KamalaIssack/Mecanum-wheel-mobile-robot-project/docs/images/hardware/buck-converter-adjustment.jpg

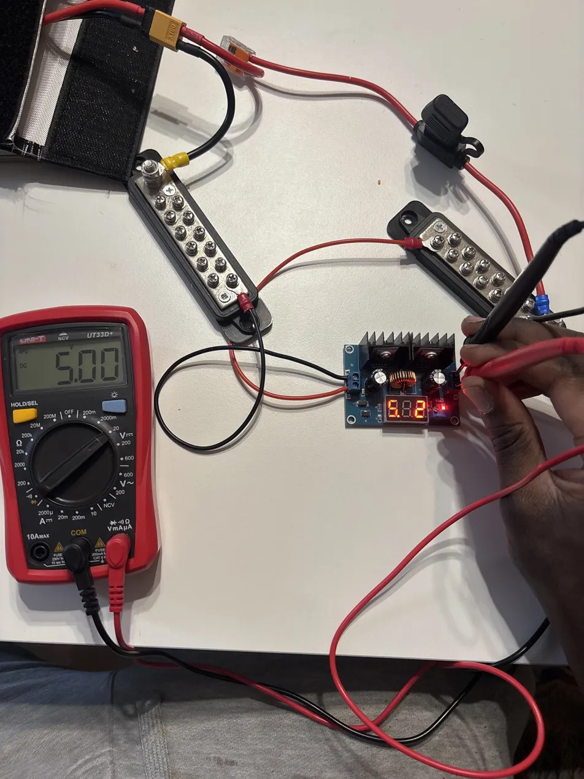
docs/images/hardware/buck-converter-adjustment.jpg
