KamalaIssack/Mecanum-wheel-mobile-robot-project/docs/images/ros2/urdf_foxglove_view.png

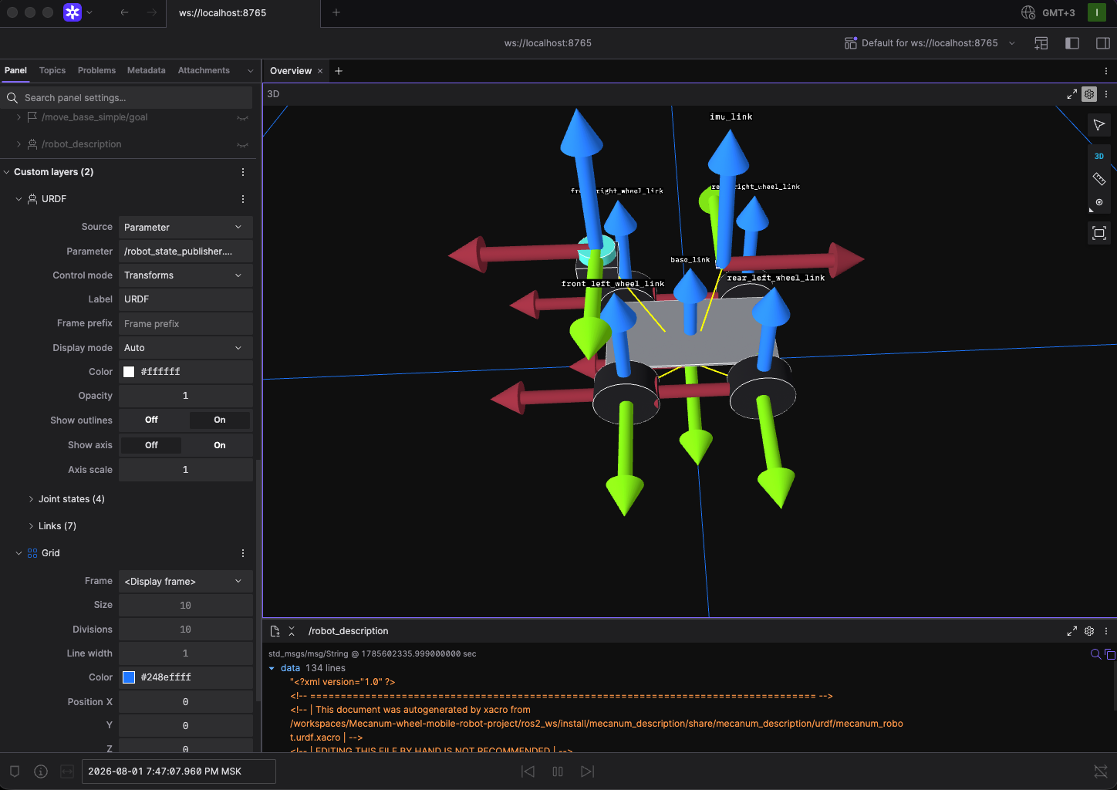
docs/images/ros2/urdf_foxglove_view.png
