KamalaIssack/Mecanum-wheel-mobile-robot-project/docs/images/stm32/phase1-led-blink.jpeg

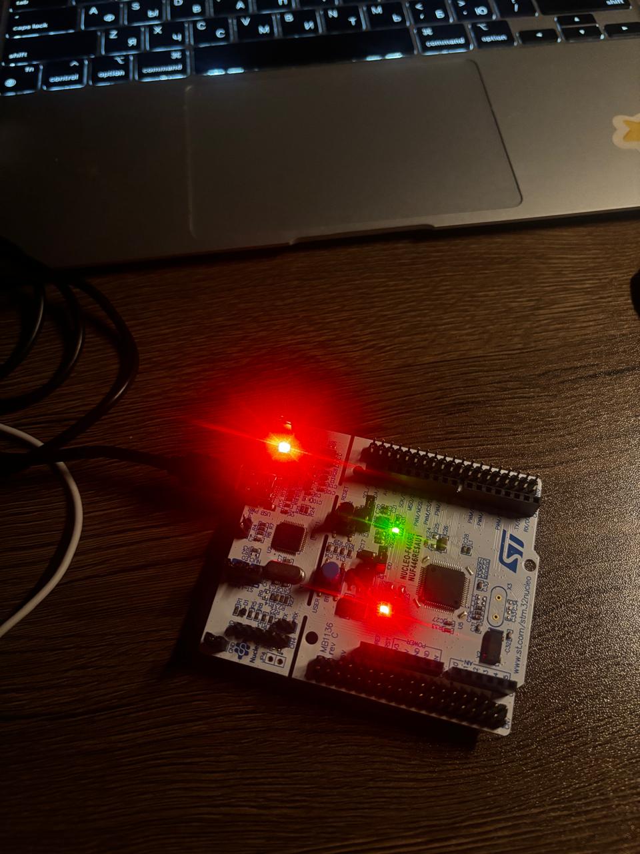
docs/images/stm32/phase1-led-blink.jpeg
