KamalaIssack/Mecanum-wheel-mobile-robot-project/docs/images/stm32/phase2-pwm-led.jpeg

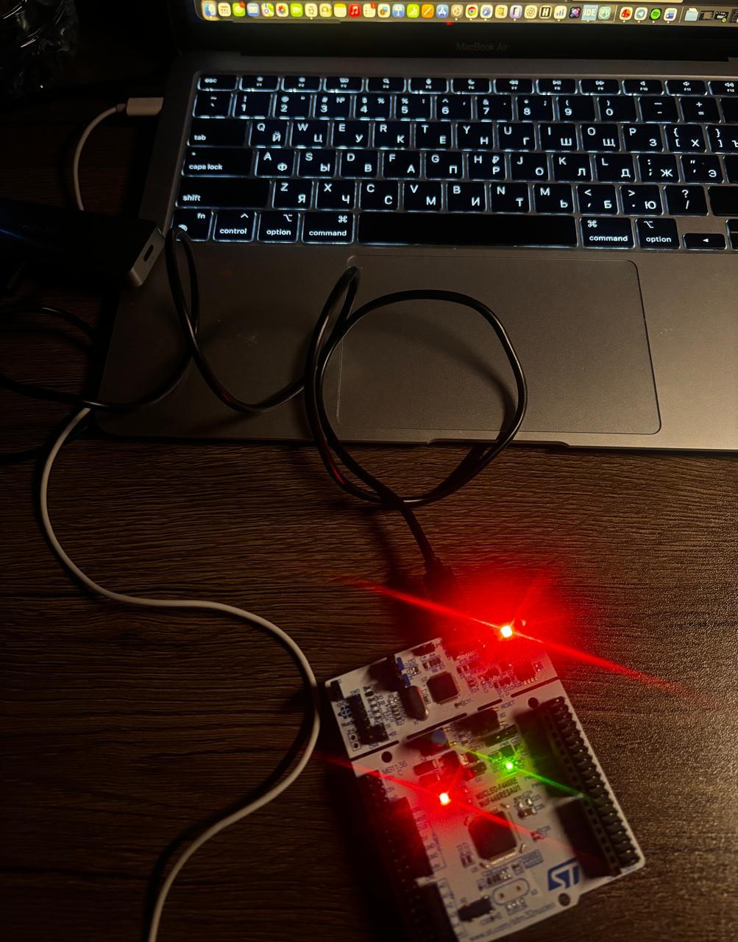
docs/images/stm32/phase2-pwm-led.jpeg
