KamalaIssack/Mecanum-wheel-mobile-robot-project/docs/images/wiring_step2.jpg

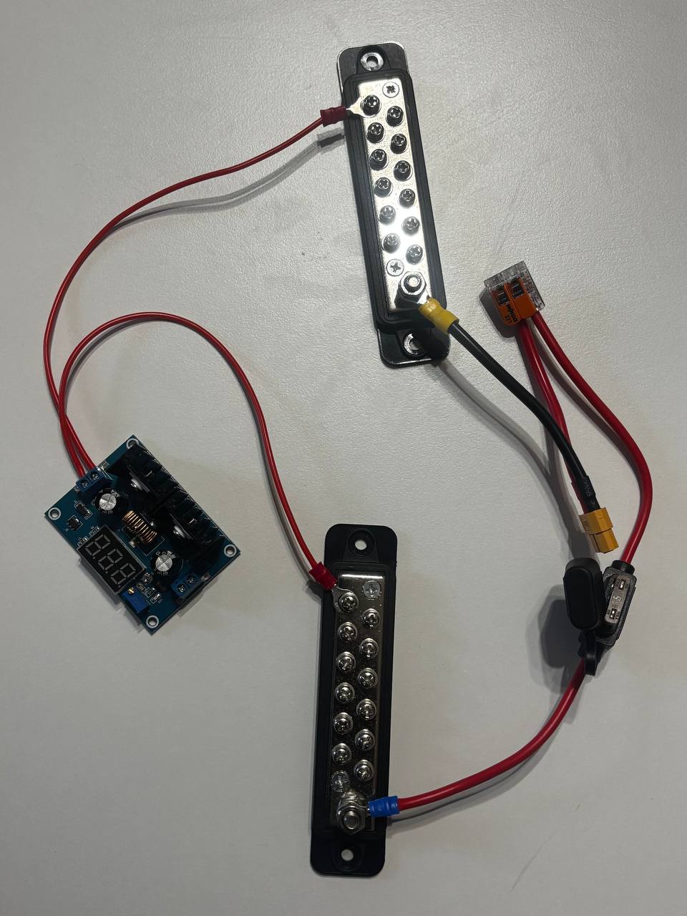
docs/images/wiring_step2.jpg
