KamalaIssack/Mecanum-wheel-mobile-robot-project/docs/images/wiring_step3.jpeg

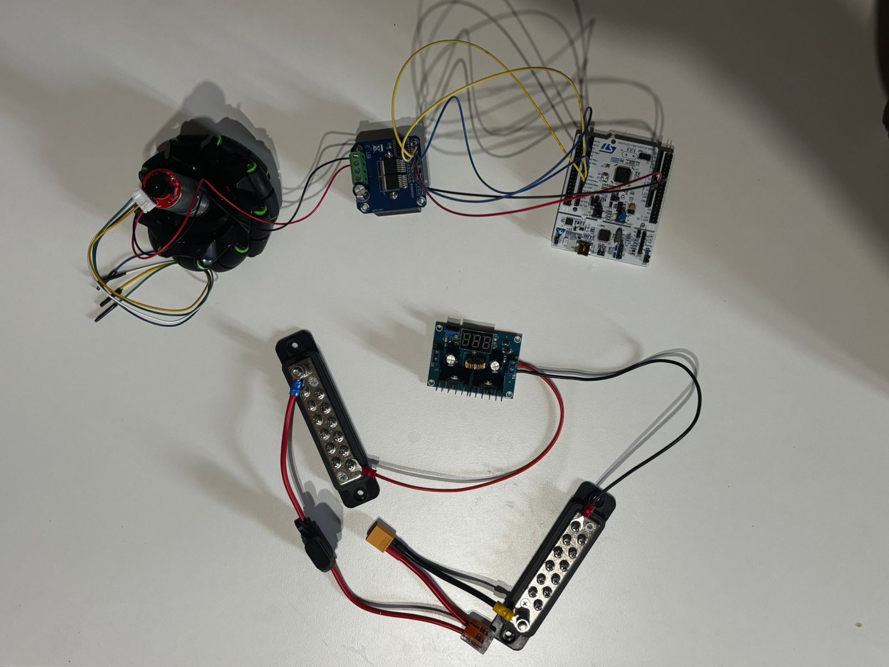
docs/images/wiring_step3.jpeg
