KamalaIssack/Mecanum-wheel-mobile-robot-project/firmware/stm32/nucleo_f446re/mecanum_drive/Core/Src/main.c

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
/* Includes ------------------------------------------------------------------*/
#include "main.h"

/* USER CODE BEGIN Includes */
#include <stdio.h>
#include <stdlib.h>
#include <string.h>
#include <math.h>
/* USER CODE END Includes */

/* USER CODE BEGIN PD */
/* 11 PPR x 4 (quadrature) x 21.3 gear ratio */
#define COUNTS_PER_REV   937.2f
/* Must match the TIM6 interrupt rate (50 Hz) */
#define TICK_SECONDS     0.02f
#define TWO_PI           6.283185f



/* Development duty ceiling out of the 999 ARR full scale: a wrong sign or a
 * runaway command crawls instead of bolting. Raised deliberately once closed
 * loop is trusted. */
#define DUTY_CEILING 300

/* Open-loop feedforward gain: ~41.9 rad/s (400 RPM no-load) maps to the 999
 * full-duty count, so 999 / 41.89 = 23.85. A first guess the PID corrects. */
#define DUTY_PER_RAD_S 23.85f

/* Largest accepted wheel command: the motor's no-load top speed. Anything
 * beyond is a malformed command and is rejected, not clamped. */
#define MAX_CMD_RAD_S 42.0f


/* Largest gain the K command accepts. Covers the tuning sweep with room to
 * probe the instability edge (around 55 to 80 for FL), and rejects a dropped
 * decimal point (300 meant as 30.0). Rejected, not clamped, like
 * MAX_CMD_RAD_S: a clamped typo would still run a gain never intended. */
#define KP_MAX 80.0f

/* Largest integral gain the I command accepts, duty counts per (rad/s x s).
 * Twice the top of the tuning sweep (Ki 200), and rejects a dropped decimal
 * point (1000 meant as 100.0). Rejected, not clamped, like KP_MAX. */
#define KI_MAX 400.0f

/* Anti-windup clamp on each wheel's integral term, in duty counts. Covers
 * every legitimate need with margin (worst case about 42: FR at low speed,
 * cold, low battery; FR needs about -30 at 12 rad/s, hence symmetric), while
 * a wheel that cannot reach its target can add at most 60 counts of wound-up
 * duty instead of hundreds. */
#define I_LIMIT 60.0f

/* Per-wheel forward-drive sign, order {FL, FR, RL, RR}.
 * Left wheels mount mirror-imaged to the right, so their encoders count the
 * opposite way and read negative when rolled forward. Corrected here in
 * firmware, never by swapping Hall wires, to keep the wiring uniform.
 * Bench-measured on a forward roll: FL -, FR +, RL -, RR +. */
#define DIR_FL (-1)
#define DIR_FR (+1)
#define DIR_RL (-1)
#define DIR_RR (+1)


/* USER CODE END PD */

TIM_HandleTypeDef htim1;
TIM_HandleTypeDef htim2;
TIM_HandleTypeDef htim3;
TIM_HandleTypeDef htim4;
TIM_HandleTypeDef htim5;
TIM_HandleTypeDef htim6;
TIM_HandleTypeDef htim8;

UART_HandleTypeDef huart2;

/* USER CODE BEGIN PV */


/* Live encoder counts - global so the debugger's Live Expressions
 * panel can watch them. Raw CNT register values, updated each loop. */
volatile uint32_t enc_fl = 0;   /* M1 front left  - TIM1 */
volatile uint32_t enc_fr = 0;   /* M2 front right - TIM8 */
volatile uint32_t enc_rl = 0;   /* M3 rear left   - TIM5 */
volatile uint32_t enc_rr = 0;   /* M4 rear right  - TIM2 */



/* Previous-tick counts, used to compute per-tick deltas */
volatile uint32_t enc_fl_prev = 0;
volatile uint32_t enc_fr_prev = 0;
volatile uint32_t enc_rl_prev = 0;
volatile uint32_t enc_rr_prev = 0;

/* Wheel velocities in rad/s, updated each TIM6 tick */
volatile float vel_fl = 0.0f;
volatile float vel_fr = 0.0f;
volatile float vel_rl = 0.0f;
volatile float vel_rr = 0.0f;



/* Raised by the TIM6 ISR when a fresh velocity sample exists, cleared by the
 * main loop once it has sent one line. volatile: crosses the ISR/main-loop
 * boundary. Single byte, so the load/store is atomic on Cortex-M4. */
volatile uint8_t tx_ready = 0;



/* ---- Command receive (USART2 RX) ---- */

/* One-byte landing slot HAL fills on each interrupt receive. */
uint8_t rx_byte = 0;

/* Ring buffer: ISR writes bytes at head, main loop reads at tail. Decouples the
 * fast interrupt from the slow line parsing. Power-of-two size so the wrap is a
 * bitmask, not a divide. Single-writer-per-index (ISR owns head, main owns
 * tail) makes it lock-free on Cortex-M4. */
#define RX_RING_SIZE 128
volatile uint8_t  rx_ring[RX_RING_SIZE];
volatile uint16_t rx_head = 0;
volatile uint16_t rx_tail = 0;

/* Commanded wheel velocities in rad/s, order FL FR RL RR. Written only by a
 * validated C,... line (atomically, see parse_command) and cleared on disarm.
 * Read by TIM6, which maps them to PWM via apply_velocity_control(). */

volatile float target_fl = 0.0f;
volatile float target_fr = 0.0f;
volatile float target_rl = 0.0f;
volatile float target_rr = 0.0f;

/* Proportional gain, duty counts per rad/s of error. Boots at 0 so a fresh
 * board reproduces the verified open loop until a K command is acknowledged.
 * No PRIMASK needed, unlike the targets: one aligned 32-bit store is atomic
 * on the M4. Survives disarm; only reset or a new K command changes it. */
volatile float kp = 0.0f;

/* Integral gain. Boots at 0, and at ki = 0 the integrals stay at 0, so a
 * fresh board runs exactly the P law of 3c0b9ff. Same rules as kp: changed
 * only while disarmed, survives disarm, atomic 32-bit store. */
volatile float ki = 0.0f;

/* Per-wheel integral term in duty counts: the controller's only memory.
 * Written by TIM6 (wheel_duty) and cleared by motors_disarm(); read by the
 * main loop for the D,... line. */
volatile float integ_fl = 0.0f;
volatile float integ_fr = 0.0f;
volatile float integ_rl = 0.0f;
volatile float integ_rr = 0.0f;

/* Watchdog: ms timestamp of the last valid velocity command. Compared against
 * HAL_GetTick() to detect a dead control link. */
volatile uint32_t last_cmd_ms = 0;

/* If armed and no valid C,... arrives within this many ms, the watchdog
 * disarms. 300 ms: a dead link stops the wheels in about a third of a
 * second. The host must command faster than this (console heartbeat 100 ms). */
#define CMD_TIMEOUT_MS 300u

/* State-change event to emit from the main loop (never transmit from an ISR).
 * 0 = nothing pending. */
volatile uint8_t status_event = 0;
#define STATUS_ARMED     1
#define STATUS_DISARMED  2
#define STATUS_TIMEOUT   3



/* Master motion permission. Starts disarmed so the board boots inert; only an
 * explicit motors_arm() permits motion. volatile: the Step 5 watchdog clears it
 * from interrupt context while the main loop reads it. */
volatile uint8_t motors_armed = 0;

/* USER CODE END PV */

void SystemClock_Config(void);
static void MX_GPIO_Init(void);
static void MX_TIM3_Init(void);
static void MX_TIM4_Init(void);
static void MX_TIM1_Init(void);
static void MX_TIM2_Init(void);
static void MX_TIM5_Init(void);
static void MX_TIM8_Init(void);
static void MX_TIM6_Init(void);
static void MX_USART2_UART_Init(void);
/* USER CODE BEGIN PFP */
void motor_set(TIM_HandleTypeDef *htim, uint32_t rpwm_ch, uint32_t lpwm_ch,
               GPIO_TypeDef *en_port, uint16_t ren_pin, uint16_t len_pin,
               int16_t speed);
void mecanum_drive(int16_t vx, int16_t vy, int16_t omega);


void encoders_read_raw(void);

void HAL_TIM_PeriodElapsedCallback(TIM_HandleTypeDef *htim);

void motors_disarm(void);
void motors_arm(void);







void process_rx(void);
static void parse_enable(const char *s);
static void parse_command(const char *s);
static int16_t wheel_duty(float target, float measured, volatile float *integ);
void apply_velocity_control(void);
static void parse_gain(const char *s);

/* USER CODE END PFP */

/**
  * @brief  The application entry point.
  * @retval int
  */
int main(void)
{

  /* MCU Configuration--------------------------------------------------------*/

  /* Reset of all peripherals, Initializes the Flash interface and the Systick. */
  HAL_Init();

  /* Configure the system clock */
  SystemClock_Config();

  /* Initialize all configured peripherals */
  MX_GPIO_Init();
  MX_TIM3_Init();
  MX_TIM4_Init();
  MX_TIM1_Init();
  MX_TIM2_Init();
  MX_TIM5_Init();
  MX_TIM8_Init();
  MX_TIM6_Init();
  MX_USART2_UART_Init();
  /* USER CODE BEGIN 2 */
  /* Start PWM on all 8 channels */
  HAL_TIM_PWM_Start(&htim3, TIM_CHANNEL_1);
  HAL_TIM_PWM_Start(&htim3, TIM_CHANNEL_2);
  HAL_TIM_PWM_Start(&htim3, TIM_CHANNEL_3);
  HAL_TIM_PWM_Start(&htim3, TIM_CHANNEL_4);
  HAL_TIM_PWM_Start(&htim4, TIM_CHANNEL_1);
  HAL_TIM_PWM_Start(&htim4, TIM_CHANNEL_2);
  HAL_TIM_PWM_Start(&htim4, TIM_CHANNEL_3);
  HAL_TIM_PWM_Start(&htim4, TIM_CHANNEL_4);


  /* Turn on hardware quadrature counting for all four encoders.
   * Without these calls the CNT registers stay frozen at 0 no
   * matter how the shafts turn. TIM_CHANNEL_ALL enables both the
   * A and B input channels together. */
  HAL_TIM_Encoder_Start(&htim1, TIM_CHANNEL_ALL);
  HAL_TIM_Encoder_Start(&htim8, TIM_CHANNEL_ALL);
  HAL_TIM_Encoder_Start(&htim5, TIM_CHANNEL_ALL);
  HAL_TIM_Encoder_Start(&htim2, TIM_CHANNEL_ALL);



  /* _IT enables the interrupt; plain Start would never fire the callback */
  HAL_TIM_Base_Start_IT(&htim6);

  /* Arm the first interrupt receive. Each byte re-arms the next inside
   * HAL_UART_RxCpltCallback, so this one call starts a self-sustaining chain. */
  HAL_UART_Receive_IT(&huart2, &rx_byte, 1);


  /* USER CODE END 2 */

  /* Infinite loop */
  /* USER CODE BEGIN WHILE */
  while (1)
  {
    /* One telemetry line per fresh TIM6 sample. The flag paces this at
     * 50 Hz, so no HAL_Delay is needed. */
    if (tx_ready)
    {
      tx_ready = 0;   /* clear before the send: a sample arriving during
                       * transmit stays pending rather than being dropped */

      /* Snapshot the volatile velocities so all four fields in a line come
       * from one instant, even if the ISR updates them mid-format. */
      float fl = vel_fl;
      float fr = vel_fr;
      float rl = vel_rl;
      float rr = vel_rr;
      float i_fl = integ_fl;
      float i_fr = integ_fr;
      float i_rl = integ_rl;
      float i_rr = integ_rr;

      char buf[64];
      int n = snprintf(buf, sizeof(buf),
                       "V,%+7.2f,%+7.2f,%+7.2f,%+7.2f\n",
                       fl, fr, rl, rr);
      if (n > 0)
      {
        HAL_UART_Transmit(&huart2, (uint8_t *)buf, (uint16_t)n, HAL_MAX_DELAY);
      }

      /* Integrals on their own line so V keeps exactly 5 fields and existing
       * host tools are unaffected. V plus D use about 30% of the link. */
      n = snprintf(buf, sizeof(buf),
                   "D,%+7.2f,%+7.2f,%+7.2f,%+7.2f\n",
                   i_fl, i_fr, i_rl, i_rr);
      if (n > 0)
      {
        HAL_UART_Transmit(&huart2, (uint8_t *)buf, (uint16_t)n, HAL_MAX_DELAY);
      }
    }


    /* Assemble and parse any received command bytes. */
    process_rx();

    /* Report any state change once, from the main loop (not the ISR). */
    if (status_event)
    {
      uint8_t e = status_event;
      status_event = 0;
      const char *msg = (e == STATUS_ARMED)    ? "S,ARMED\n"    :
                        (e == STATUS_DISARMED) ? "S,DISARMED\n" :
                                                 "S,TIMEOUT\n";
      HAL_UART_Transmit(&huart2, (uint8_t *)msg, (uint16_t)strlen(msg), HAL_MAX_DELAY);
    }
    /* USER CODE END WHILE */


    /* USER CODE BEGIN 3 */
  }
  /* USER CODE END 3 */
}
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
/* USER CODE BEGIN 4 */
/* Cut all motor output and forbid motion. Zero the duty BEFORE dropping the
 * enables: the timers keep running, so a channel left with a stale compare value
 * would resume that speed the instant something re-armed. */
void motors_disarm(void)
{

	motors_armed = 0;

    __HAL_TIM_SET_COMPARE(&htim3, TIM_CHANNEL_1, 0);
    __HAL_TIM_SET_COMPARE(&htim3, TIM_CHANNEL_2, 0);
    __HAL_TIM_SET_COMPARE(&htim3, TIM_CHANNEL_3, 0);
    __HAL_TIM_SET_COMPARE(&htim3, TIM_CHANNEL_4, 0);
    __HAL_TIM_SET_COMPARE(&htim4, TIM_CHANNEL_1, 0);
    __HAL_TIM_SET_COMPARE(&htim4, TIM_CHANNEL_2, 0);
    __HAL_TIM_SET_COMPARE(&htim4, TIM_CHANNEL_3, 0);
    __HAL_TIM_SET_COMPARE(&htim4, TIM_CHANNEL_4, 0);


    HAL_GPIO_WritePin(GPIOC, M1_REN_Pin|M1_LEN_Pin|M2_REN_Pin|M2_LEN_Pin
                            |M3_REN_Pin|M3_LEN_Pin|M4_REN_Pin|M4_LEN_Pin,
                            GPIO_PIN_RESET);

    /* Forget commanded intent so a later arm can never inherit stale motion. */
    target_fl = 0.0f;
    target_fr = 0.0f;
    target_rl = 0.0f;
    target_rr = 0.0f;
    /* Safe against a concurrent TIM6 tick: motors_armed is already 0, so the
     * ISR clears these too. This clear is what makes every arm start clean,
     * since motors_arm() may set armed again before TIM6 next runs. */
    integ_fl = 0.0f;
    integ_fr = 0.0f;
    integ_rl = 0.0f;
    integ_rr = 0.0f;


    HAL_GPIO_WritePin(LD2_GPIO_Port, LD2_Pin, GPIO_PIN_RESET);   /* LED off */
}

/* Permit motion. Disarms first so arming can never inherit a stale duty. */
void motors_arm(void)
{
    motors_disarm();


    HAL_GPIO_WritePin(GPIOC, M1_REN_Pin|M1_LEN_Pin|M2_REN_Pin|M2_LEN_Pin
                            |M3_REN_Pin|M3_LEN_Pin|M4_REN_Pin|M4_LEN_Pin,
                            GPIO_PIN_SET);

    last_cmd_ms = HAL_GetTick();   /* fresh timer so we do not instant-trip */
    motors_armed = 1;
    HAL_GPIO_WritePin(LD2_GPIO_Port, LD2_Pin, GPIO_PIN_SET);   /* LED on */
}

void motor_set(TIM_HandleTypeDef *htim, uint32_t rpwm_ch, uint32_t lpwm_ch,
               GPIO_TypeDef *en_port, uint16_t ren_pin, uint16_t len_pin,
               int16_t speed)
{
    /* Gate here, not at the call site, so every caller inherits it. */
    if (!motors_armed)
    {
        __HAL_TIM_SET_COMPARE(htim, rpwm_ch, 0);
        __HAL_TIM_SET_COMPARE(htim, lpwm_ch, 0);
        return;
    }
    uint16_t duty = (uint16_t)(speed < 0 ? -speed : speed);
    if (duty > DUTY_CEILING) duty = DUTY_CEILING;

    if (speed > 0)
    {
        __HAL_TIM_SET_COMPARE(htim, rpwm_ch, duty);
        __HAL_TIM_SET_COMPARE(htim, lpwm_ch, 0);
    }
    else if (speed < 0)
    {
        __HAL_TIM_SET_COMPARE(htim, rpwm_ch, 0);
        __HAL_TIM_SET_COMPARE(htim, lpwm_ch, duty);
    }
    else
    {
        __HAL_TIM_SET_COMPARE(htim, rpwm_ch, 0);
        __HAL_TIM_SET_COMPARE(htim, lpwm_ch, 0);
    }
}

void mecanum_drive(int16_t vx, int16_t vy, int16_t omega)
{
    int16_t fl = vx - vy - omega;
    int16_t fr = vx + vy + omega;
    int16_t rl = vx + vy - omega;
    int16_t rr = vx - vy + omega;

    motor_set(&htim3, TIM_CHANNEL_1, TIM_CHANNEL_2, GPIOC, M1_REN_Pin, M1_LEN_Pin, fl);
    motor_set(&htim3, TIM_CHANNEL_3, TIM_CHANNEL_4, GPIOC, M2_REN_Pin, M2_LEN_Pin, fr);
    motor_set(&htim4, TIM_CHANNEL_1, TIM_CHANNEL_2, GPIOC, M3_REN_Pin, M3_LEN_Pin, rl);
    motor_set(&htim4, TIM_CHANNEL_3, TIM_CHANNEL_4, GPIOC, M4_REN_Pin, M4_LEN_Pin, rr);
}


/* Feedforward plus P plus I for one wheel. Target, measured speed and duty
 * must share the forward-positive sign convention (DIR_* on the encoder
 * side); a flip on any wheel turns the feedback positive.
 *
 * Clamps in float BEFORE the int16_t cast: an out-of-range float-to-int
 * conversion is undefined, and on this target it keeps the low 16 bits, so
 * 40000.0 becomes -25536, a full reverse that motor_set()'s own clamp cannot
 * undo. A corrupted encoder delta alone can reach that range. */
static int16_t wheel_duty(float target, float measured, volatile float *integ)
{
    float e = target - measured;

    /* The controller runs every tick, armed or not: P is stateless, but the
     * integral would wind up against a wheel that cannot move. A zero target
     * means stop; without this reset the integral holds its last value on a
     * stopped wheel (standing current, sitting just under breakaway), while
     * P still does the braking. Zero is exact here: never computed, only
     * parsed or cleared. A reversal is deliberately not a reset: its large
     * error flips the integral's sign within two ticks. */
    if (!motors_armed || target == 0.0f)
    {
        *integ = 0.0f;
    }
    else
    {
        /* Stored in duty counts (Ki x e x dt), and the stored value itself is
         * clamped: limiting only its contribution would let a hidden value
         * keep growing and still lurch the wheel while it unwound. */
        float i = *integ + ki * e * TICK_SECONDS;
        if (i >  I_LIMIT) i =  I_LIMIT;
        if (i < -I_LIMIT) i = -I_LIMIT;
        *integ = i;
    }

    float d = DUTY_PER_RAD_S * target + kp * e + *integ;

    if (d >  (float)DUTY_CEILING) d =  (float)DUTY_CEILING;
    if (d < -(float)DUTY_CEILING) d = -(float)DUTY_CEILING;

    return (int16_t)d;
}

/* At kp = ki = 0 this yields exactly the open-loop duty; at ki = 0 exactly
 * the P law of 3c0b9ff, which is what makes those bench runs baselines. With
 * kp > 0 a zero target actively holds the wheel (brief reverse pulse when
 * stopping); only disarm freewheels. motor_set() owns the arm gate. Channel
 * mapping matches mecanum_drive(): M1=FL, M2=FR on TIM3; M3=RL, M4=RR on
 * TIM4. Each wheel keeps its own integral: they need different values. */
void apply_velocity_control(void)
{
    int16_t d_fl = wheel_duty(target_fl, vel_fl, &integ_fl);
    int16_t d_fr = wheel_duty(target_fr, vel_fr, &integ_fr);
    int16_t d_rl = wheel_duty(target_rl, vel_rl, &integ_rl);
    int16_t d_rr = wheel_duty(target_rr, vel_rr, &integ_rr);

    motor_set(&htim3, TIM_CHANNEL_1, TIM_CHANNEL_2, GPIOC, M1_REN_Pin, M1_LEN_Pin, d_fl);
    motor_set(&htim3, TIM_CHANNEL_3, TIM_CHANNEL_4, GPIOC, M2_REN_Pin, M2_LEN_Pin, d_fr);
    motor_set(&htim4, TIM_CHANNEL_1, TIM_CHANNEL_2, GPIOC, M3_REN_Pin, M3_LEN_Pin, d_rl);
    motor_set(&htim4, TIM_CHANNEL_3, TIM_CHANNEL_4, GPIOC, M4_REN_Pin, M4_LEN_Pin, d_rr);
}

/* Reads the live count out of each encoder timer's CNT register.
 * __HAL_TIM_GET_COUNTER just peeks the current value - it does not
 * reset anything. Updates the four global enc_* variables so the
 * debugger's Live Expressions panel can watch them change. */
void encoders_read_raw(void)
{
    enc_fl = __HAL_TIM_GET_COUNTER(&htim1);
    enc_fr = __HAL_TIM_GET_COUNTER(&htim8);
    enc_rl = __HAL_TIM_GET_COUNTER(&htim5);
    enc_rr = __HAL_TIM_GET_COUNTER(&htim2);
}


/* Fires every 20ms via TIM6. Guarded on TIM6 because this HAL callback
 * is shared by all period-elapsed timers. Signed-width casts must match
 * each timer's register width so counter wraparound resolves correctly:
 * int16_t for TIM1/TIM8 (16-bit), int32_t for TIM5/TIM2 (32-bit). */
void HAL_TIM_PeriodElapsedCallback(TIM_HandleTypeDef *htim)
{
    if (htim->Instance == TIM6)
    {
        encoders_read_raw();


        /* Cast to the timer's signed width before applying DIR_* so a counter
         * wrap unwraps correctly (int16 TIM1/TIM8, int32 TIM5/TIM2). */
        int16_t d_fl = DIR_FL * (int16_t)(enc_fl - enc_fl_prev);
        int16_t d_fr = DIR_FR * (int16_t)(enc_fr - enc_fr_prev);
        int32_t d_rl = DIR_RL * (int32_t)(enc_rl - enc_rl_prev);
        int32_t d_rr = DIR_RR * (int32_t)(enc_rr - enc_rr_prev);

        vel_fl = (float)d_fl * TWO_PI / COUNTS_PER_REV / TICK_SECONDS;
        vel_fr = (float)d_fr * TWO_PI / COUNTS_PER_REV / TICK_SECONDS;
        vel_rl = (float)d_rl * TWO_PI / COUNTS_PER_REV / TICK_SECONDS;
        vel_rr = (float)d_rr * TWO_PI / COUNTS_PER_REV / TICK_SECONDS;


        enc_fl_prev = enc_fl;
        enc_fr_prev = enc_fr;
        enc_rl_prev = enc_rl;
        enc_rr_prev = enc_rr;


        tx_ready = 1;

        /* Command watchdog. Only meaningful while armed. Unsigned subtraction
         * is wrap-safe. On timeout, disarm (which latches) and flag the event
         * for the main loop to report. */
        if (motors_armed && (HAL_GetTick() - last_cmd_ms > CMD_TIMEOUT_MS))
        {
            motors_disarm();
            status_event = STATUS_TIMEOUT;
        }

        /* Runs after the watchdog on purpose: if it disarmed this tick,
         * motor_set() already sees motors_armed == 0 and writes zero. */
        apply_velocity_control();

    }
}


/* One byte arrived on USART2. Kept tiny: stash and re-arm. No parsing here;
 * float parsing in an ISR would stall and risk dropping the next byte (this
 * UART has no RX FIFO). */
void HAL_UART_RxCpltCallback(UART_HandleTypeDef *huart)
{
    if (huart->Instance == USART2)
    {
        uint16_t next = (rx_head + 1u) & (RX_RING_SIZE - 1u);
        if (next != rx_tail)          /* store only if not full */
        {
            rx_ring[rx_head] = rx_byte;
            rx_head = next;
        }
        /* If full, drop the byte; newline framing resyncs on the next line. */

        HAL_UART_Receive_IT(&huart2, &rx_byte, 1);   /* re-arm */
    }
}

/* A latched UART error (e.g. overrun) can stop interrupt reception dead.
 * Re-arming clears it and keeps RX alive for the rest of the session. */
void HAL_UART_ErrorCallback(UART_HandleTypeDef *huart)
{
    if (huart->Instance == USART2)
    {
        HAL_UART_Receive_IT(&huart2, &rx_byte, 1);
    }
}

/* Parse "C,<fl>,<fr>,<rl>,<rr>" into the four targets, then echo "A,..." so the
 * host sees exactly what we understood. Any deviation (wrong tag, missing
 * number or comma) drops the line silently; the next newline resyncs. strtof
 * (not sscanf) avoids pulling in scanf-float support. */
static void parse_command(const char *s)
{
    if (s[0] != 'C' || s[1] != ',')
        return;

    const char *p = s + 2;
    char *end;
    float v[4];

    for (int i = 0; i < 4; i++)
    {
        v[i] = strtof(p, &end);
        if (end == p)                 /* no digits consumed => malformed */
            return;
        p = end;
        if (i < 3)
        {
            if (*p != ',')
                return;
            p++;
        }
    }



    /* Reject the whole command if any value is non-finite or beyond what the
     * motor can physically do. A rejected command does not feed the watchdog,
     * so a sender streaming garbage cannot keep the robot armed. */
    for (int i = 0; i < 4; i++)
    {
        if (!isfinite(v[i]) || fabsf(v[i]) > MAX_CMD_RAD_S)
            return;
    }

    /* TIM6 reads these targets, so publish all four plus the watchdog stamp
     * with interrupts masked: the ISR sees all-old or all-new, never a mix.
     * Restore PRIMASK rather than force-enable, so this is safe to nest. */
    uint32_t primask = __get_PRIMASK();
    __disable_irq();
    target_fl = v[0];
    target_fr = v[1];
    target_rl = v[2];
    target_rr = v[3];
    last_cmd_ms = HAL_GetTick();
    __set_PRIMASK(primask);


    char buf[64];
    int n = snprintf(buf, sizeof(buf), "A,%+7.2f,%+7.2f,%+7.2f,%+7.2f\n",
                     v[0], v[1], v[2], v[3]);
    if (n > 0)
        HAL_UART_Transmit(&huart2, (uint8_t *)buf, (uint16_t)n, HAL_MAX_DELAY);
}


/* "E,1" arms (clears the latch), "E,0" disarms. Only this path can arm; a
 * velocity command never can, which is what makes the stop latch hold. */
static void parse_enable(const char *s)
{
    if (s[1] != ',') return;
    if (s[2] == '1')      { motors_arm();    status_event = STATUS_ARMED;    }
    else if (s[2] == '0') { motors_disarm(); status_event = STATUS_DISARMED; }
}



/* "K,<kp>" or "I,<ki>" sets that gain and replies "A,K,<kp>" or "A,I,<ki>".
 * One parser because every rule is shared; only the limit, the variable and
 * the ack letter come from the tag. Accepted only while disarmed, so a gain
 * change never steps the duty under a spinning wheel or mixes two gains in
 * one log. No race between the check and the store: only the main loop can
 * arm; the ISR can only disarm. Trailing characters are rejected because
 * strtof would read "K,3O" as 3. Rejections are silent; the host detects the
 * missing ack. */
static void parse_gain(const char *s)
{
    if (s[1] != ',')
        return;
    if (motors_armed)
        return;

    const char tag = s[0];                       /* 'K' or 'I', see process_rx */
    const float limit = (tag == 'K') ? KP_MAX : KI_MAX;

    const char *p = s + 2;
    char *end;
    float v = strtof(p, &end);

    if (end == p || *end != '\0')
        return;
    if (!isfinite(v) || v < 0.0f || v > limit)
        return;

    if (tag == 'K')
        kp = v;
    else
        ki = v;

    char buf[24];
    int n = snprintf(buf, sizeof(buf), "A,%c,%.2f\n", tag, v);
    if (n > 0)
        HAL_UART_Transmit(&huart2, (uint8_t *)buf, (uint16_t)n, HAL_MAX_DELAY);
}

/* Drain the ring, assembling bytes into a line until '\n', then parse it. Runs
 * in the main loop where slow work is safe. line[]/idx are static: one command
 * can arrive spread across several loop iterations. */
void process_rx(void)
{
    static char     line[64];
    static uint16_t idx = 0;

    while (rx_tail != rx_head)
    {
        char c = (char)rx_ring[rx_tail];
        rx_tail = (rx_tail + 1u) & (RX_RING_SIZE - 1u);



        if (c == '\n')
        {
            line[idx] = '\0';
            if (line[0] == 'E')
                parse_enable(line);
            else if (line[0] == 'K' || line[0] == 'I')
                parse_gain(line);
            else
                parse_command(line);
            idx = 0;
        }


        else if (c == '\r')
        {
            /* ignore CR (tolerate CRLF) */
        }
        else if (idx < sizeof(line) - 1)
        {
            line[idx++] = c;
        }
        else
        {
            idx = 0;   /* overlong line: discard, resync on next newline */
        }
    }
}


/* USER CODE END 4 */
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
