KamalaIssack/Mecanum-wheel-mobile-robot-project/firmware/stm32/nucleo_f446re/mecanum_drive/mecanum_drive.ioc

Mcu.UserName=STM32F446RETx
PA0-WKUP.Signal=S_TIM5_CH1
PA1.Signal=S_TIM5_CH2
PA13.GPIO_Label=TMS
PA13.Signal=SYS_JTMS-SWDIO
PA14.GPIO_Label=TCK
PA14.Signal=SYS_JTCK-SWCLK
PA15.Signal=S_TIM2_CH1_ETR
PA2.GPIO_Label=USART_TX
PA2.Signal=USART2_TX
PA3.GPIO_Label=USART_RX
PA3.Signal=USART2_RX
PA5.GPIO_Label=LD2 [Green Led]
PA5.Signal=GPIO_Output
PA6.Signal=S_TIM3_CH1
PA7.Signal=S_TIM3_CH2
PA8.Signal=S_TIM1_CH1
PA9.Signal=S_TIM1_CH2
PB0.Signal=S_TIM3_CH3
PB1.Signal=S_TIM3_CH4
PB3.Signal=S_TIM2_CH2
PB6.Signal=S_TIM4_CH1
PB7.Signal=S_TIM4_CH2
PB8.Signal=S_TIM4_CH3
PB9.Signal=S_TIM4_CH4
PC0.GPIO_Label=M1_REN
PC0.Signal=GPIO_Output
PC1.GPIO_Label=M1_LEN
PC1.Signal=GPIO_Output
PC10.GPIO_Label=M4_REN
PC10.Signal=GPIO_Output
PC11.GPIO_Label=M4_LEN
PC11.Signal=GPIO_Output
PC13.GPIO_Label=B1 [Blue PushButton]
PC13.Signal=GPXTI13
PC14-OSC32_IN.Signal=RCC_OSC32_IN
PC15-OSC32_OUT.Signal=RCC_OSC32_OUT
PC2.GPIO_Label=M2_REN
PC2.Signal=GPIO_Output
PC3.GPIO_Label=M2_LEN
PC3.Signal=GPIO_Output
PC6.Signal=S_TIM8_CH1
PC7.Signal=S_TIM8_CH2
PC8.GPIO_Label=M3_REN
PC8.Signal=GPIO_Output
PC9.GPIO_Label=M3_LEN
PC9.Signal=GPIO_Output
PH0-OSC_IN.Signal=RCC_OSC_IN
PH1-OSC_OUT.Signal=RCC_OSC_OUT
