KamalaIssack/Mecanum-wheel-mobile-robot-project/firmware/stm32/nucleo_f446re/mecanum_drive/Core/Inc/main.h

#define B1_Pin GPIO_PIN_13
#define B1_GPIO_Port GPIOC
#define M1_REN_Pin GPIO_PIN_0
#define M1_REN_GPIO_Port GPIOC
#define M1_LEN_Pin GPIO_PIN_1
#define M1_LEN_GPIO_Port GPIOC
#define M2_REN_Pin GPIO_PIN_2
#define M2_REN_GPIO_Port GPIOC
#define M2_LEN_Pin GPIO_PIN_3
#define M2_LEN_GPIO_Port GPIOC
#define USART_TX_Pin GPIO_PIN_2
#define USART_TX_GPIO_Port GPIOA
#define USART_RX_Pin GPIO_PIN_3
#define USART_RX_GPIO_Port GPIOA
#define LD2_Pin GPIO_PIN_5
#define LD2_GPIO_Port GPIOA
#define M3_REN_Pin GPIO_PIN_8
#define M3_REN_GPIO_Port GPIOC
#define M3_LEN_Pin GPIO_PIN_9
#define M3_LEN_GPIO_Port GPIOC
#define TMS_Pin GPIO_PIN_13
#define TMS_GPIO_Port GPIOA
#define TCK_Pin GPIO_PIN_14
#define TCK_GPIO_Port GPIOA
#define M4_REN_Pin GPIO_PIN_10
#define M4_REN_GPIO_Port GPIOC
#define M4_LEN_Pin GPIO_PIN_11
#define M4_LEN_GPIO_Port GPIOC
