KamalaIssack/Mecanum-wheel-mobile-robot-project/(commit log)

2026-02-02 STM32 support
2026-02-02 Add STM32CubeIDE Nucleo F446RE blink project
2026-02-13 Add STM32 Nucleo F446RE example projects and gitignore
2026-02-13 Add STM32 Phase 1 & 2 development log
2026-02-15 Add STM32 Phase 1 and Phase 2 images
2026-03-01 Add Phase 3: single motor test - TIM3 PWM + BTS7960 control
2026-04-02 Update README with actual project details and current status
2026-04-02 Add wiring step 2 photo
2026-04-29 Remove single_motor_test — will redo in Step 3D
2026-05-06 Add Phase 3: mecanum_drive firmware - 4-motor PWM control with kinematics
    - TIM3 + TIM4 each driving 2 BTS7960 motor drivers (8 PWM channels total)
    - mecanum_drive(vx, vy, omega) implements full mecanum wheel kinematics
    - Test loop: forward drive and strafe right at 50% speed
    - Excludes Drivers/ (regenerate from mecanum_drive.ioc via STM32CubeMX)
    - Updated .gitignore to exclude **/Drivers/ from all STM32 projects
2026-05-06 Add hardware photos: buck converter adjustment and wiring step 3
2026-06-13 Phase 3 complete: 4-motor bench verification video
2026-06-13 docs: add Phase 3 completed entry to STM32 development log
    Replaces the upcoming placeholder with a full write-up of the single
    motor test — BTS7960 wiring, TIM3 PWM configuration, direction/speed
    control code, results, and inline video embed.
2026-07-30 docs: add Deck 1 power wiring build log, Deck 2 status, and completion roadmap
    Deck 1 power distribution wired, calibrated and tested: star topology
    from inline fuse through bus bars to 4x BTS7960 and 2x XL4016E1 buck
    converters. Buck A at 5.10V for Raspberry Pi 5, Buck B at 5.00V for
    Nucleo, both verified with multimeter. Wiring photo added.
    Deck 2 (compute and sensing layer) marked as in progress with planned
    component list: RPi 5, Nucleo, RPLIDAR C1, MPU-9250, E-stop.
    README expanded with:
    - Three status tables (hardware, firmware, ROS 2)
    - Full Build Log section
    - Seven-stage Roadmap to Completion
    - Complete BOM covering power system and compute/sensing
    - Robot geometry section
    - Worki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
2026-07-30 docs: add Deck 1 top-down wiring photo and two-column image layout
    Top-down view shows all 4 mecanum wheels, both bus bars, 4x BTS7960
    (IBT-2) drivers, and 2x XL4016E1 bucks clearly in one shot. README
    updated to display isometric and top-down photos side by side.
2026-07-30 docs: replace Deck 1 top-down photo with correct orientation
    Previous image was upside-down. Replaced with correctly oriented
    top-down view: front BTS7960 drivers at top, positive and negative
    bus bars in the middle, rear BTS7960 drivers at bottom.
2026-08-01 Add mecanum_description package with robot URDF
    - new package mecanum_description (ament_cmake), holds robot geometry independent of mecanum_tf, so Gazebo/RViz/robot_state_publisher/Nav2 can depend on just the description
    - urdf/mecanum_robot.urdf.xacro: base_link (placeholder chassis box, real dimensions pending caliper measurement), lidar_link fixed at the real 0.20/0.15 offset, four wheel links via a reusable xacro:macro using the real lx/ly=0.1m lever arms and provisional 0.0483m wheel radius
    - wheel joints are type=continuous with axis xyz=0 1 0, correctly oriented for rotation, unlike the fixed lidar joint
    - CMakeLists.txt: install urdf/ directory so the file is discoverable via get_pa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
    [mecanum_robot.urdf.xacro]
2026-08-01 Replace placeholder URDF dimensions with measured values; base_link at ground level
    [mecanum_robot.urdf.xacro]
2026-08-01 feat: import mecanum_interfaces from mecanum_actions_ws
    Adds WheelSpeeds.msg, ResetOdometry.srv, and MoveForSeconds.action.
    Imported as a single commit; per-interface development history is in
    the mecanum_actions_ws learning repository.
2026-08-01 docs: update README for ros2_ws addition and src/ removal
    Project Structure now reflects the real tree (firmware/, ros2_ws/,
    hardware/, docs/, config/, tests/, scripts/); the old empty src/
    scaffolding is gone. Adds a two-part architecture section describing
    the STM32 firmware / Raspberry Pi 5 ROS 2 workspace split.
2026-08-01 ros2/urdf_foxglove_view.png
    docs: add URDF Foxglove render
2026-08-01 docs: move URDF render into images/ros2 subfolder
2026-08-01 feat: add mecanum_bringup package with system launch file
    Adds bringup.launch.py which starts robot_state_publisher,
    joint_state_publisher, and foxglove_bridge together, so the full
    visualization stack comes up with one command. Bridge port is a
    launch argument (default 8765).
2026-08-04 Fix .gitignore swallowing ROS package manifests
    The repo-wide *.xml rule (under KiCad) was ignoring every package.xml,
    which left mecanum_interfaces and mecanum_bringup with no manifest in
    the repo. colcon skips any directory without a package.xml, so a fresh
    clone would silently build neither package. Neutralised the broad rule
    and added an absolute un-ignore guard for package.xml so no future broad
    rule can drop a manifest again.
    EOF
2026-08-04 Add mecanum_control package skeleton (ament_python)
    Empty package for the kinematics node and future Nucleo serial bridge.
    Declares rclpy, geometry_msgs, nav_msgs, tf2_ros, mecanum_interfaces.
    Builds and registers; entry_points intentionally empty until the node lands.
2026-08-04 Add mecanum_kinematics node: inverse kinematics cmd_vel to wheel_speeds
    Stateless node maps geometry_msgs/Twist on /cmd_vel to mecanum_interfaces/WheelSpeeds on /wheel_speeds (rad/s), with per-wheel saturation to max_wheel_speed.
    Sign matrix (FL,RR rollers backslash; FR,RL rollers forward-slash) locked from a physical hand-spin test on the robot, then validated live in all three pure motions:
    - forward: all four wheels equal positive (~20.7 rad/s)
    - left strafe: FL,RR negative / FR,RL positive
    - CCW yaw: left negative / right positive (~4.14 rad/s)
    Parameters (wheel_radius, lx, ly, max_wheel_speed) loaded from mecanum_bringup/config/mecanum_kinematics.yaml via control.launch.py.
    Node name,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
2026-08-05 Add mecanum_odometry node: forward kinematics + dead-reckoning odometry
    Stateful ament_python node. Subscribes /wheel_speeds(mecanum_interfaces/WheelSpeeds), integrates pose on a fixed 50 Hz timer, publishes /odom (nav_msgs/Odometry) and broadcasts the odom->base_link TF. Chosen timer-based design (not subscriber-driven) to give regular dt and match eventual EKF fusion at 50 Hz.
    Three math layers: forward kinematics (wheel speeds -> body velocity, the inverse of node 1's matrix, read column-wise), rotate body velocity into the odom frame by heading theta, integrate with real measured dt (first-tick guarded). Planar yaw->quaternion written by hand (qz=sin(theta/2), qw=cos(theta/2)); tf_trans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
    [mecanum_odometry.py]
2026-08-08 Make URDF physics-ready for Gazebo: inertia + collision on all links
    Add reusable box_inertial and cylinder_inertial xacro macros that compute the inertia tensor from mass and geometry (standard solid-body formulas), so tensors always match the shapes.
    Every link now has mass, inertia, and collision:
    - base_link: 3.0 kg. Inertia uses a realistic mass envelope (0.13 m tall box centered at z=0.135) rather than the 3 mm visual plate, so the stacked-robot mass distribution simulates stably instead of behaving like a thin sheet. Visual/collision keep the real plate.
    - four wheels: 0.08 kg each. Cylinder inertial passed a rpy=pi/2 origin so the axial term lands on the y spin axis, matching the wh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
    [mecanum_robot.urdf.xacro]
2026-08-09 Add Gazebo MecanumDrive plugin in a separate sim-only xacro fragment
    New mecanum_robot.gazebo.xacro holds simulation-only content, included from the main URDF via $(find mecanum_description). Keeps sim machinery out of the pure robot description: inertia and collision describe the real robot, the drive plugin is a stand-in for the STM32 motor control that only exists inside Gazebo.
    Configures gz::sim::systems::MecanumDrive with the four wheel joints and the locked geometry (wheel_separation 0.2, wheelbase 0.2, wheel_radius 0.0483). Publishes odom and tf on Gazebo transport at 50 Hz; a ros_gz_bridge is still needed to connect these to ROS.
    Route A chosen deliberately: the built-in plugin ge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
    [mecanum_robot.gazebo.xacro, mecanum_robot.urdf.xacro]
2026-08-11 feat: publish and bridge joint states from Gazebo
    [mecanum_robot.gazebo.xacro]
2026-08-12 refactor: make odometry output topic and TF broadcast configurable
2026-08-12 feat: add joint state adapter and simulation comparison launch
2026-08-19 feat: add quadrature encoder mode for all four wheels
    Configure TIM1 (FL, PA8/PA9), TIM8 (FR, PC6/PC7), TIM5 (RL, PA0/PA1), and TIM2 (RR, PA15/PB3) in TI1+TI2 encoder mode with input filter 15. Switched SYS debug from Trace Asynchronous to Serial Wire to free PB3 (SWO), keeping SWD on PA13/PA14 intact. 16-bit timers use full 65535 period; 32-bit timers use full 4294967295 period. Encoders read by polling, no NVIC interrupts. Builds clean.
2026-08-20 feat: read raw encoder counts each loop for bring-up test
    Start all four timers in encoder mode (TIM1 FL, TIM8 FR, TIM5 RL, TIM2 RR) and poll raw CNT registers into volatile globals each ~20ms loop, so counts can be watched live in the debugger. Open-loop motor test loop temporarily commented out so motors stay idle during the hand-spin encoder verification; restore by removing the comment markers.
2026-08-22 feat: compute wheel velocities via 50Hz TIM6 interrupt
    Add TIM6 as a 50Hz time-base (PSC 8999, ARR 199 on 90MHz APB1) with its NVIC interrupt enabled. HAL_TIM_PeriodElapsedCallback reads all four encoders each tick and converts count deltas to rad/s, using signed width-matched casts (int16_t for TIM1/TIM8, int32_t for TIM5/TIM2) so counter wraparound resolves to the correct small delta. Encoder reads moved out of the main loop into the interrupt for precise timing. Not yet flash-tested on hardware.
    [main.c, mecanum_drive.ioc]
2026-08-23 docs: verify velocity on hardware, note sign convention open item
    Velocity calculation confirmed working on the physical M1 encoder via Live Expressions: vel_fl tracks hand-spin speed and direction and returns to zero at rest, while unwired channels stay at zero. Documented that per-wheel velocity sign is not yet fixed; because mecanum wheels mount mirrored L/R, signs must be locked at chassis integration against the kinematics matrix (M1 unmounted read negative for hand-chosen forward).
    [main.c]
2026-08-28 feat: forward-positive per-wheel sign convention for encoder velocities
2026-09-06 docs: rewrite README to reflect full 4-motor drive, safety layer, and ROS 2 stack
    Firmware has moved well past the single-motor-test stage: full mecanum
    drive, all four encoders, forward-positive sign convention, disarm-at-boot
    safety layer, and first powered drive under battery are all done. ROS 2
    side now has kinematics, odometry, and a validated Gazebo simulation.
    Corrects buck converter assignments, fills in confirmed robot geometry,
    removes the dropped e-stop hardware, and documents the real safety
    architecture (battery disconnect, planned watchdog, explicit disarm).
2026-09-14 feat: stream measured wheel velocities over USART2 at 50 Hz
2026-09-16 feat: receive and parse wheel-velocity commands over USART2
2026-09-21 feat: add command watchdog with explicit arm and latching disarm
2026-10-01 feat: open-loop wheel drive from validated serial commands
2026-10-01 feat: tighten command watchdog to 300 ms
2026-10-12 feat: P-only closed-loop wheel velocity control with live K gain
    Each wheel's duty is feedforward plus Kp*(target - measured), computed in the 50 Hz TIM6 callback and clamped to DUTY_CEILING. K,<kp> sets the gain (0 to 80) only while disarmed and is acked as A,K,<kp>; non-finite, negative, out-of-range and trailing-junk values are rejected silently. kp boots at 0, so a reset reproduces the verified open loop.
    Bench-verified wheels-up on all four wheels: Kp 0 matches the piece 1 open loop, a Kp 10/20/40 sweep follows error = e0/(1 + k*Kp), and the 300 ms watchdog kill test and latch pass.
2026-10-13 feat: step-response logger and plotter for wheel velocity tuning
    step_logger.py runs one velocity step on one wheel: disarm, set the gain with a required A,K ack, arm, then settle/hold/post phases with a 100 ms heartbeat. It logs board-clocked telemetry to CSV with the acknowledged target as the step edge, and disarms on every exit path. This is the version used for the 2026-10-12 Kp sweep on all four wheels.
    plot_step.py overlays runs aligned on their acknowledged step edges and reports mean, error, jitter, overshoot in whole encoder counts, 63% rise time and dropped lines. It handles backward steps, and names multi-run plots after their contents. Verified against the 2026-10-12 bench data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
2026-10-13 docs: Step 6 piece 2 P-control bench results (2026-10-12)
    Raw step-response CSVs for the Kp 0/10/20/40 sweep on all four wheels, warm-up and direction tests, and the no-motor-power runs; plots regenerated with tools/plot_step.py; README with setup, verification, per-graph findings, challenges, and the case for integral action in piece 3.
2026-10-13 docs: correct bench README details and update main README for P control
    Bench README: move the no-motor-power image to its own section, point the braking notes at the sweep plots, correct the suspected cause of the missing S,DISARMED reply, and separate the deliberate USB dry run from the unplugged-battery runs. Main README: watchdog 300 ms, F9 P control complete with a link to the bench results, F10 integral action planned, K command and step tools documented, bench folder added to the structure tree.
2026-10-20 feat(firmware): PI wheel velocity control with integral clamp and D telemetry
    Adds integral action to the per-wheel velocity loop:
    duty = 23.85*target + Kp*e + I, clamped to +/-300, with
    I += Ki*e*0.02 clamped to +/-60.
    - New I,<ki> command (0 to 400, accepted only while disarmed, ack A,I,<ki>).
    Out-of-range, malformed or armed-time gains get no reply.
    - Integral reset whenever disarmed or the target is 0; all four integrals
    are also cleared in motors_disarm().
    - New D,<i_fl>,<i_fr>,<i_rl>,<i_rr> telemetry line after every V line.
    - K and I share one parse_gain() path.
    Control law host-tested (27 unit tests, regression over 102,245 cases).
    CubeIDE build: 0 errors, 0 warnings. Bench-ver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
2026-10-20 feat(tools): Ki and integral telemetry in logger and plotter, add i_check
    step_logger.py:
    - --ki option; K and I are both sent before every run with their acks
    required. I is sent even at Ki 0 because the board keeps ki across disarm.
    - D lines are paired with their V line into i_fl..i_rr columns (left empty
    for firmware without D telemetry).
    - --lead-target/--lead for windup tests (hold a lead speed, then step).
    - Robustness fixes from the 2026-10-12 session: 0.2 s port settle before
    the first write, one E,0 retry, no-motion check (0.5 s) with
    --allow-no-motion for USB-only runs, incomplete runs moved to failed/,
    exit status 0 only for a complete run.
    plot_step.py:
    - Ki, lead and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
2026-10-20 docs: PI control bench results (2026-10-19)
    Ki sweep (50/100/200) at Kp 10 and windup tests on all four wheels.
    PI removes the P-only steady-state error (0.36 to 0.68 rad/s down to
    0.00); Kp 10 / Ki 100 confirmed as one gain set; the +/-60 clamp holds
    windup. FR shows a once-per-revolution drag (period scales with speed),
    a mechanical issue logged for a wheel-swap test. Main README updated:
    F10 complete, I/D protocol, i_check.py.
2026-11-01 feat: Nucleo serial bridge node in mecanum_control (stage R5)
    Professional version of the Session C bridge. Parameters load from mecanum_bringup/config/nucleo_bridge.yaml; the board state is published on /nucleo_status (transient local); missing velocity acks raise one warning; a lost serial port ends the node with one log line and exit code 1; a bare newline precedes the first E,0 and a retry is logged. Parsing, ramp and stale-command logic are pure functions covered by 25 pytest cases. Bench-verified wheels up on 2026-10-30 (six bridge tests) and 2026-11-01 (B1 to B6).
2026-11-02 docs: R5 Nucleo bridge bench write-up (2026-10-30 and 2026-11-01)
    Adds the bench write-up for the nucleo_bridge node: setup, protocol and handshake,
    the D1 USB-path check from the Pi, the D2 bridge tests and checks B1 to B6,
    both plots, battery readings, challenges and the data file index.
2026-11-02 docs: README marks R5 Nucleo serial bridge complete
    Marks R5 and roadmap stage 6 complete, describes the bridge's topic contract,
    host-side safety guards and data flow (with the pending /wheel_speeds_cmd remap),
    and adds run instructions and known issues.
