KamalaIssack/Mecanum-wheel-mobile-robot-project/(notices)

Notices in the files:
firmware/stm32/nucleo_f446re/mecanum_drive/Core/Inc/main.h:
All rights reserved.
This software is licensed under terms that can be found in the LICENSE file
